Ashleyyyzamora/Ginhawa/docs/power-board-realistic.png

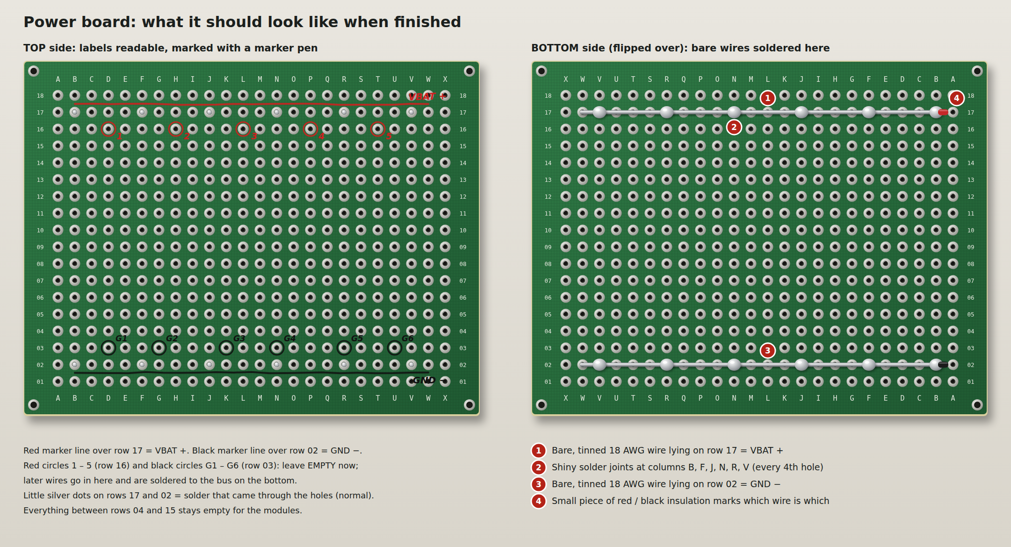
docs/power-board-realistic.png
