Ashleyyyzamora/Ginhawa/docs/power-board-what-to-look-for.png

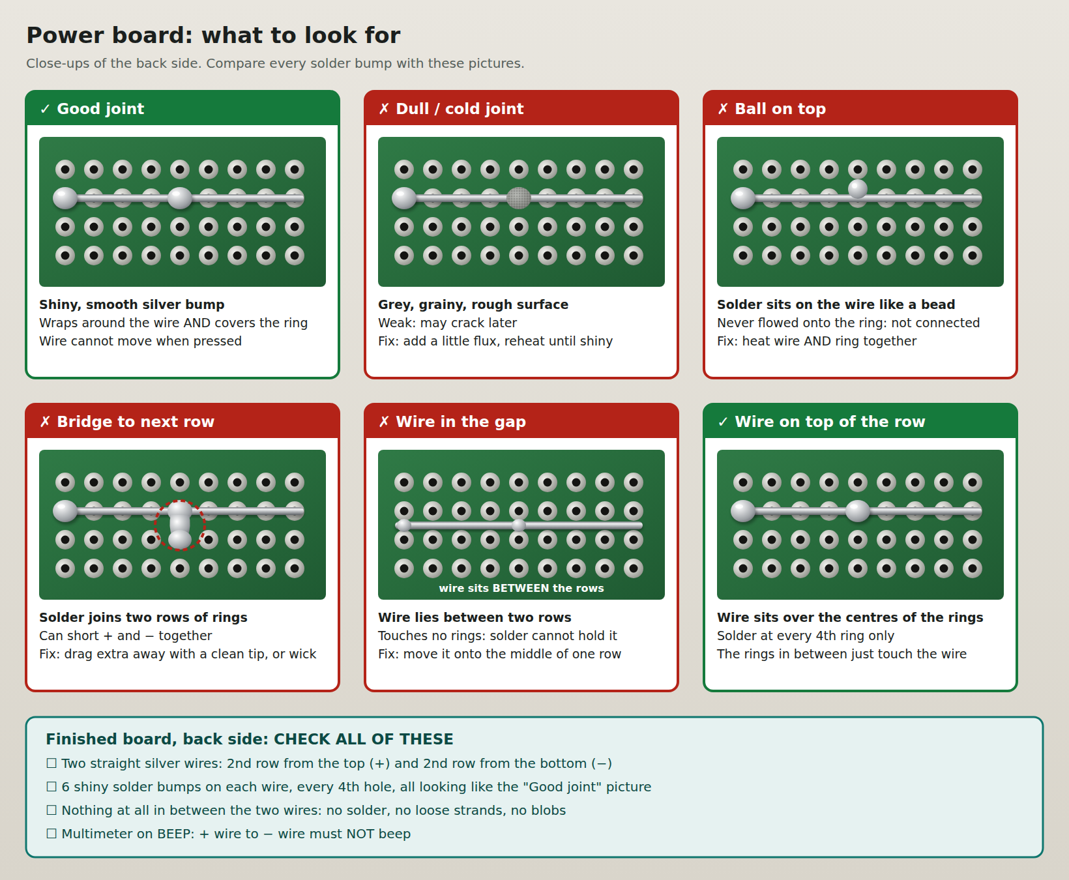
docs/power-board-what-to-look-for.png
