Ashleyyyzamora/Ginhawa/docs/power-board-layout.png

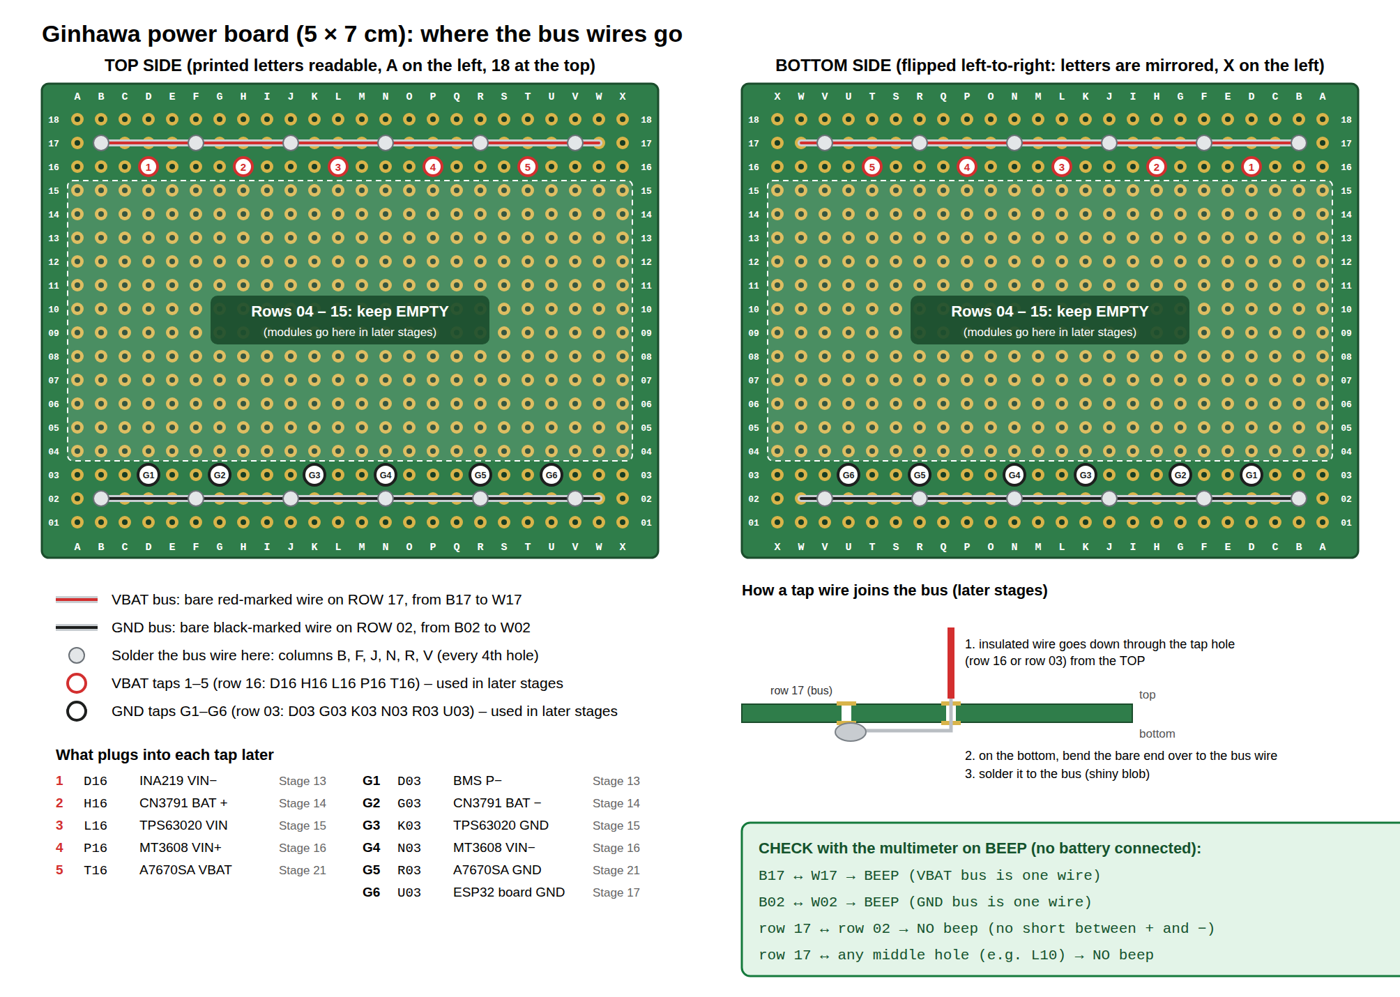
docs/power-board-layout.png
