Ashleyyyzamora/Ginhawa/docs/GINHAWA_Build_Manual_Diagrams.pdf

GINHAWA · AIR-QUALITY STATION

# Station Build Manual: Diagrams

All the figures from the build manual, one per page. Follow the full manual for the steps and checks.

1. Block diagram of the station power and data paths (Stage 1:
What you are building)
2. Parallel, series and short-circuit connections compared (Stage 2: Electricity in plain words)
3. Sketches of the tools needed for the build (Stage 4: Tools and workspace)
4. How to use a multimeter for voltage and continuity (Stage 6: Skill: using the multimeter)
5. Resistor colour bands for 4.7 kilo-ohm (Stage 6: Skill: using the multimeter)
6. Good and bad solder joints (Stage 7: Skill: soldering)
7. Four steps of through-hole soldering (Stage 7: Skill: soldering)
8. Four steps to solder a wire to a pad (Stage 7: Skill: soldering)
9. Practice perfboard with five soldering exercises (Stage 7: Skill: soldering)
10. Steps to strip, twist and tin a wire (Stage 8: Skill: wires, heat-shrink, headers and connectors)
11. Three steps to use heat-shrink tubing (Stage 8: Skill: wires, heat-shrink, headers and connectors)
12. How to cut a female header strip (Stage 8: Skill: wires, heat-shrink, headers and connectors)
13. Screw terminal, plug cable, JST GH and u.FL connectors (Stage 8: Skill: wires, heat-shrink, headers and connectors)
14. Battery holder with three cells in parallel (Stage 11: Build the battery pack)
15. Wiring of holder, BMS, fuse and INA219 (Stage 11: Build the battery pack)
16. Steps to make a bus wire on perfboard (Stage 12: Make the power board)
17. Power board layout with VBAT and GND bus wires (Stage 12: Make the power board)
18. Solar panel and CN3791 wiring (Stage 14: Solar panel and charger (CN3791))
19. TPS63020 and MT3608 wiring and adjustment (Stage 15: 3.3 V converter (TPS63020))
20. ESP32 DevKit V1 pinout with the used pins highlighted (Stage 17: Make the ESP32 board)
21. ESP32 board layout with rails and pull-up resistors (Stage 17: Make the ESP32 board)
22. Arduino IDE preferences dialog with the boards URL field (Stage 18: Install the Arduino IDE and drivers)
23. Windows Device Manager showing the ESP32 COM port (Stage 18: Install the Arduino IDE and drivers)
24. Labelled sketch of the Arduino IDE window (Stage 19: Your first program: Blink)
25. SEN55 connector pins and their connections (Stage 20: Connect the SEN55 and INA219, then test)

26. A7670SA breakout wiring with antennas and capacitors (Stage 21: Connect the 4G modem (A7670SA) and test)
27. Electrolytic capacitor polarity and parallel connection (Stage 21: Connect the 4G modem (A7670SA) and test)
28. Serial Monitor with baud rate and line ending settings (Stage 23: Upload the Ginhawa firmware)
29. Enclosure drilling plan and internal layout (Stage 25: Prepare the enclosure)
30. Steps to drill holes and cut a window in the box (Stage 25: Prepare the enclosure)
31. Pole mounting with tilted solar panel above the station box (Stage 27: Mount it outside)

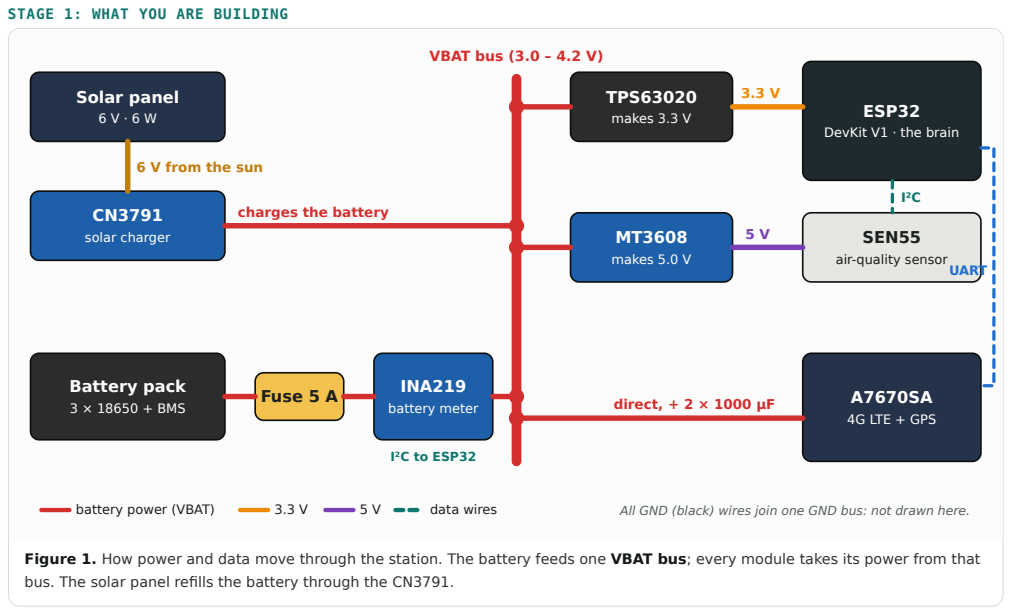
[picture p76: page 3]
VBAT bus (3.0 – 4.2 V); Solar panel; solar charger; Battery pack; 3 × 18650 + BMS; Fuse 5 A; INA219; battery meter; TPS63020; makes 3.3 V; makes 5.0 V; 4G LTE + GPS; direct, + 2 × 1000 µF; I²C; UART; I²C to ESP32; battery power (VBAT); data wires; All GND (black) wires join one GND bus: not drawn here.

STAGE 1: WHAT YOU ARE BUILDING

ESP32
DevKit V1 · the brain

6 V from the sun

charges the battery

SEN55
air-quality sensor

Figure 1. How power and data move through the station. The battery feeds one VBAT bus; every module takes its power from that
bus. The solar panel refills the battery through the CN3791.

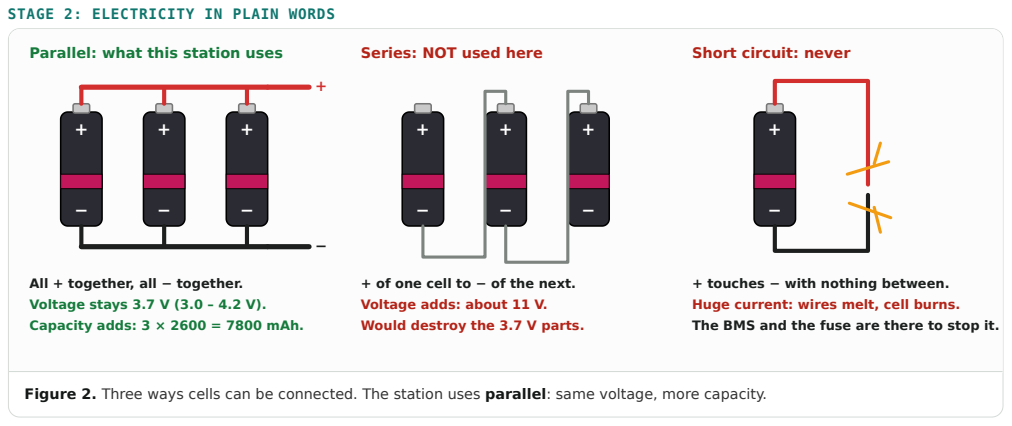
[picture p77: page 4]

STAGE 2: ELECTRICITY IN PLAIN WORDS

Parallel: what this station uses

Series: NOT used here

Short circuit: never

All + together, all − together.
Voltage stays 3.7 V (3.0 – 4.2 V).
Capacity adds: 3 × 2600 = 7800 mAh.

+ of one cell to − of the next.
Voltage adds: about 11 V.
Would destroy the 3.7 V parts.

+ touches − with nothing between.
Huge current: wires melt, cell burns.
The BMS and the fuse are there to stop it.

Figure 2. Three ways cells can be connected. The station uses parallel: same voltage, more capacity.

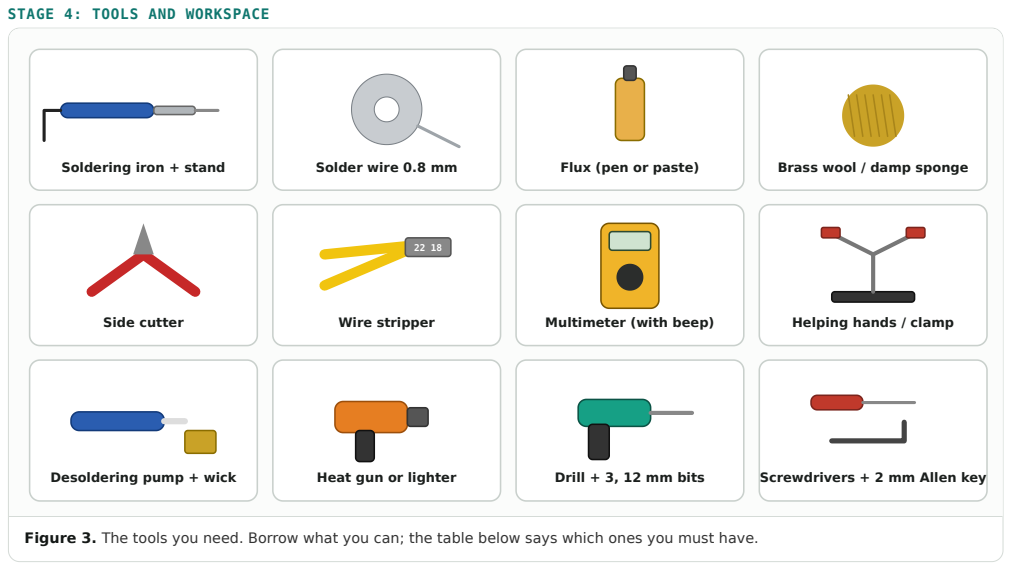
[picture p78: page 5]
Soldering iron + stand; Solder wire 0.8 mm; Flux (pen or paste); Brass wool / damp sponge; Side cutter; Wire stripper; Multimeter (with beep); Helping hands / clamp; Desoldering pump + wick; Heat gun or lighter; Drill + 3, 12 mm bits; Screwdrivers + 2 mm Allen key

STAGE 4: TOOLS AND WORKSPACE

Figure 3. The tools you need. Borrow what you can; the table below says which ones you must have.

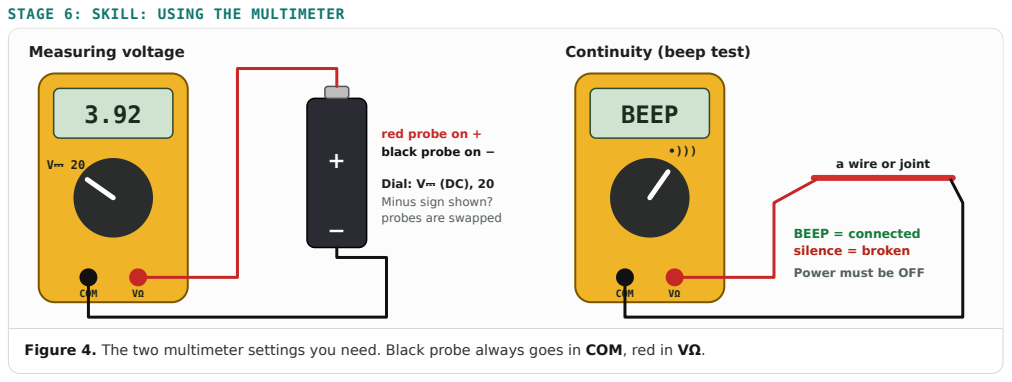
[picture p79: page 6]
Measuring voltage; COM; BEEP

STAGE 6: SKILL: USING THE MULTIMETER

Continuity (beep test)

red probe on +
black probe on −

a wire or joint

Dial: V⎓ (DC), 20
Minus sign shown?
probes are swapped

BEEP = connected
silence = broken
Power must be OFF

Figure 4. The two multimeter settings you need. Black probe always goes in COM, red in VΩ.

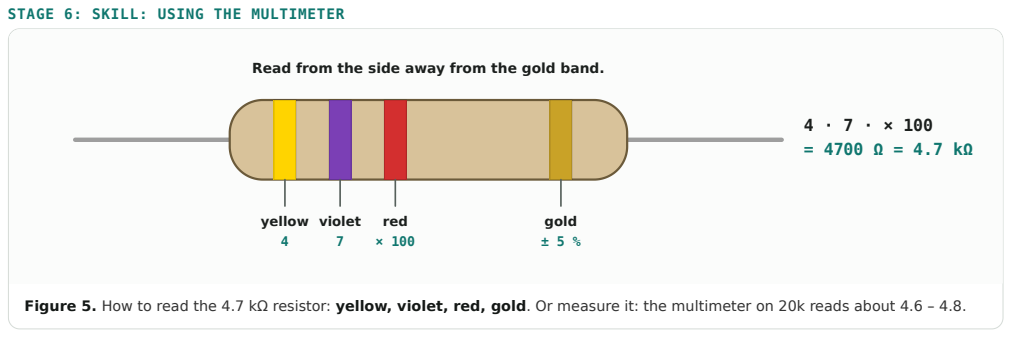
[picture p80: page 7]
yellow 4; violet 7; red × 100; gold ± 5 %

STAGE 6: SKILL: USING THE MULTIMETER

Read from the side away from the gold band.

Figure 5. How to read the 4.7 kΩ resistor: yellow, violet, red, gold. Or measure it: the multimeter on 20k reads about 4.6 – 4.8.

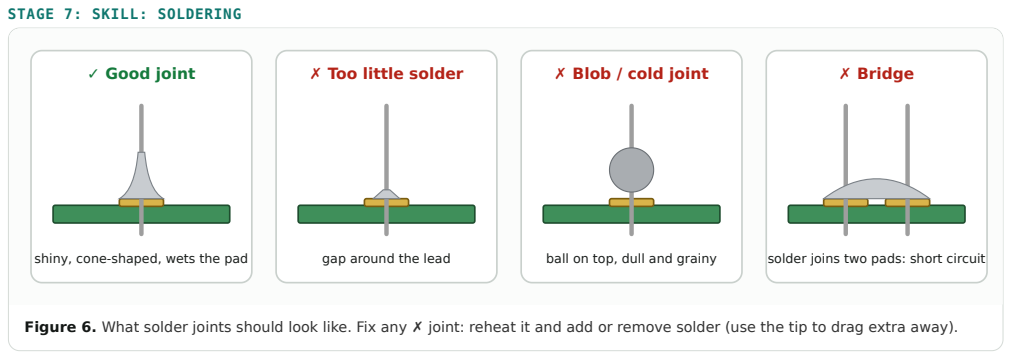
[picture p81: page 8]
✓ Good joint; ✗ Bridge

STAGE 7: SKILL: SOLDERING

✗ Too little solder

✗ Blob / cold joint

shiny, cone-shaped, wets the pad

gap around the lead

ball on top, dull and grainy

solder joins two pads: short circuit

Figure 6. What solder joints should look like. Fix any ✗ joint: reheat it and add or remove solder (use the tip to drag extra away).

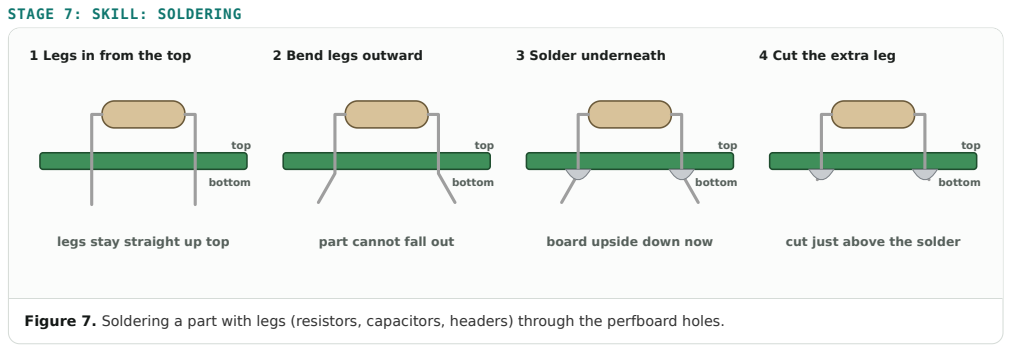
[picture p82: page 9]
top; bottom; 3 Solder underneath

STAGE 7: SKILL: SOLDERING

1 Legs in from the top

2 Bend legs outward

4 Cut the extra leg

legs stay straight up top

part cannot fall out

board upside down now

cut just above the solder

Figure 7. Soldering a part with legs (resistors, capacitors, headers) through the perfboard holes.

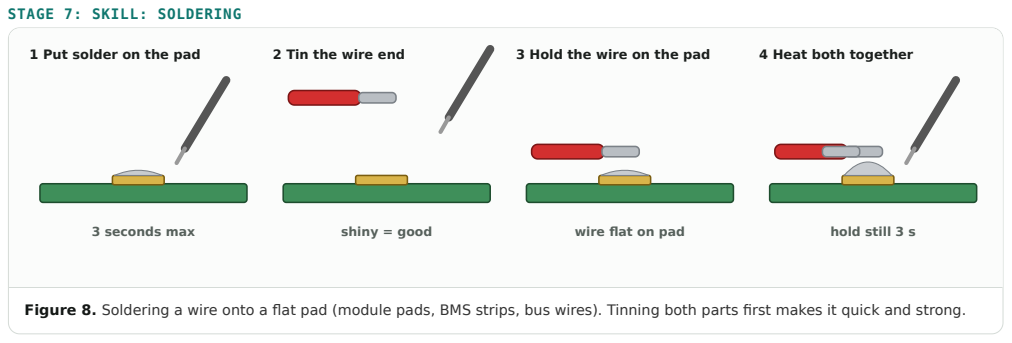
[picture p83: page 10]
3 seconds max; shiny = good; hold still 3 s

STAGE 7: SKILL: SOLDERING

1 Put solder on the pad

2 Tin the wire end

3 Hold the wire on the pad

4 Heat both together

wire flat on pad

Figure 8. Soldering a wire onto a flat pad (module pads, BMS strips, bus wires). Tinning both parts first makes it quick and strong.

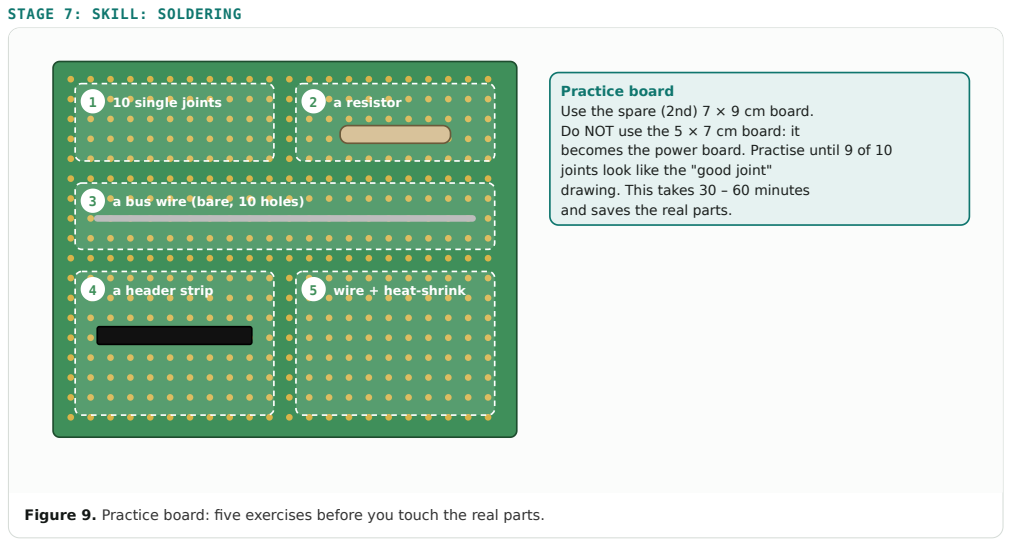
[picture p84: page 11]
1 10 single joints; 2 a resistor; 4 a header strip; 5 wire + heat-shrink

STAGE 7: SKILL: SOLDERING

Practice board
Use the spare (2nd) 7 × 9 cm board.
Do NOT use the 5 × 7 cm board: it
becomes the power board. Practise until 9 of 10
joints look like the "good joint"
drawing. This takes 30 – 60 minutes
and saves the real parts.

3 a bus wire (bare, 10 holes)

Figure 9. Practice board: five exercises before you touch the real parts.

STAGE 8: SKILL: WIRES, HEAT-SHRINK, HEADERS AND CONNECTORS

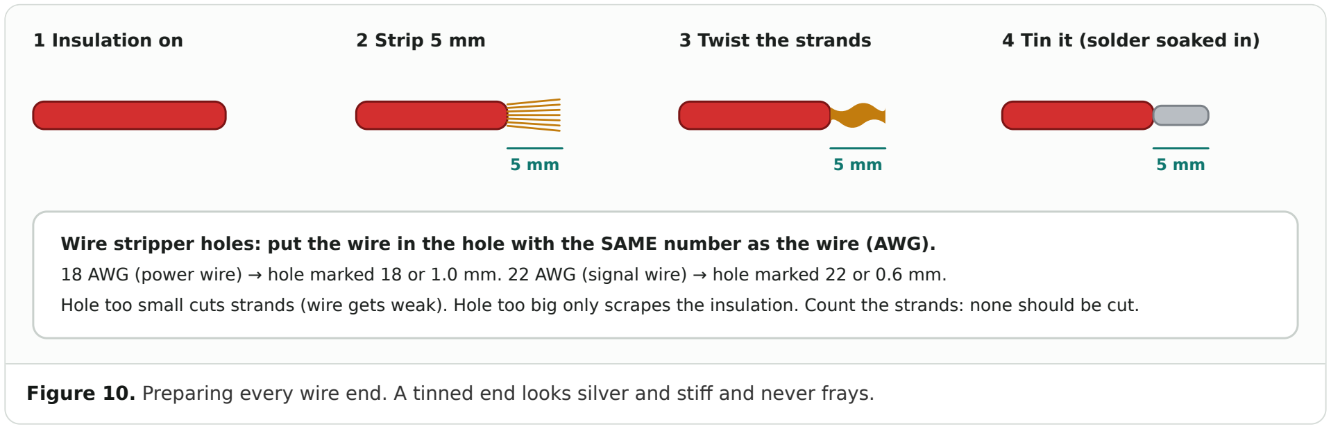
[picture p85: figure]
1 Insulation on; 2 Strip 5 mm; 3 Twist the strands; 4 Tin it (solder soaked in)

Wire stripper holes: put the wire in the hole with the SAME number as the wire (AWG).
18 AWG (power wire) → hole marked 18 or 1.0 mm. 22 AWG (signal wire) → hole marked 22 or 0.6 mm.
Hole too small cuts strands (wire gets weak). Hole too big only scrapes the insulation. Count the strands: none should be cut.

Figure 10. Preparing every wire end. A tinned end looks silver and stiff and never frays.

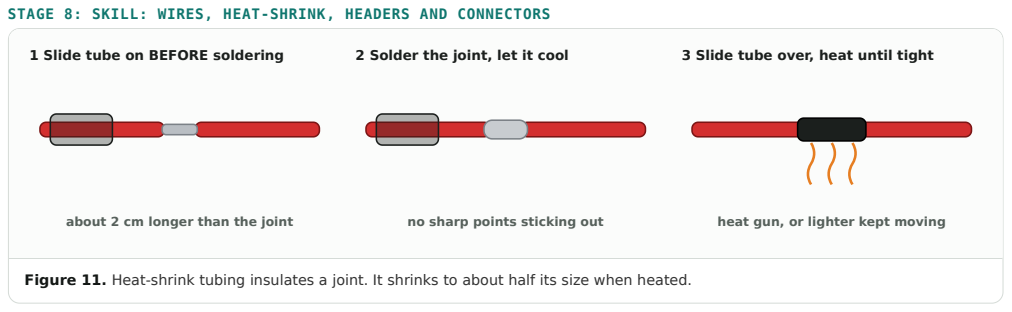
[picture p86: page 13]

STAGE 8: SKILL: WIRES, HEAT-SHRINK, HEADERS AND CONNECTORS

1 Slide tube on BEFORE soldering

2 Solder the joint, let it cool

3 Slide tube over, heat until tight

about 2 cm longer than the joint

no sharp points sticking out

heat gun, or lighter kept moving

Figure 11. Heat-shrink tubing insulates a joint. It shrinks to about half its size when heated.

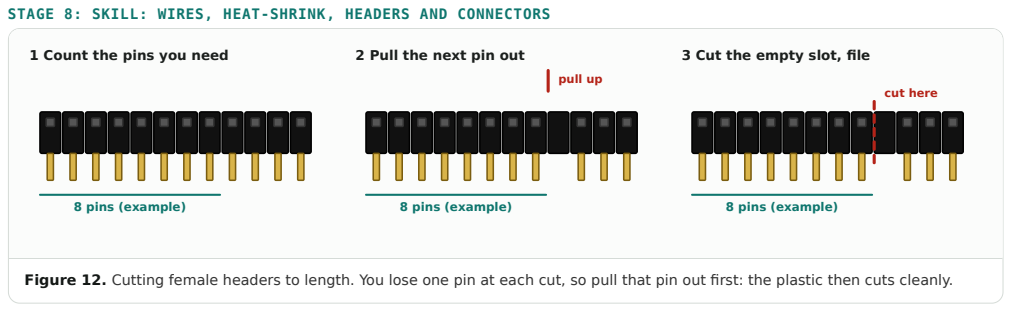
[picture p87: page 14]
8 pins (example); pull up; cut here

STAGE 8: SKILL: WIRES, HEAT-SHRINK, HEADERS AND CONNECTORS

1 Count the pins you need

2 Pull the next pin out

3 Cut the empty slot, file

Figure 12. Cutting female headers to length. You lose one pin at each cut, so pull that pin out first: the plastic then cuts cleanly.

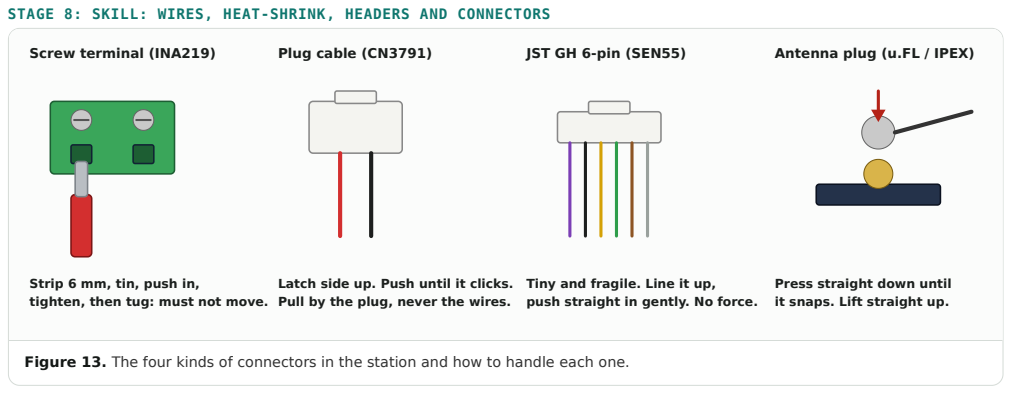
[picture p88: page 15]
Screw terminal (INA219); Plug cable (CN3791)

STAGE 8: SKILL: WIRES, HEAT-SHRINK, HEADERS AND CONNECTORS

JST GH 6-pin (SEN55)

Antenna plug (u.FL / IPEX)

Strip 6 mm, tin, push in,
tighten, then tug: must not move.

Latch side up. Push until it clicks.
Pull by the plug, never the wires.

Tiny and fragile. Line it up,
push straight in gently. No force.

Press straight down until
it snaps. Lift straight up.

Figure 13. The four kinds of connectors in the station and how to handle each one.

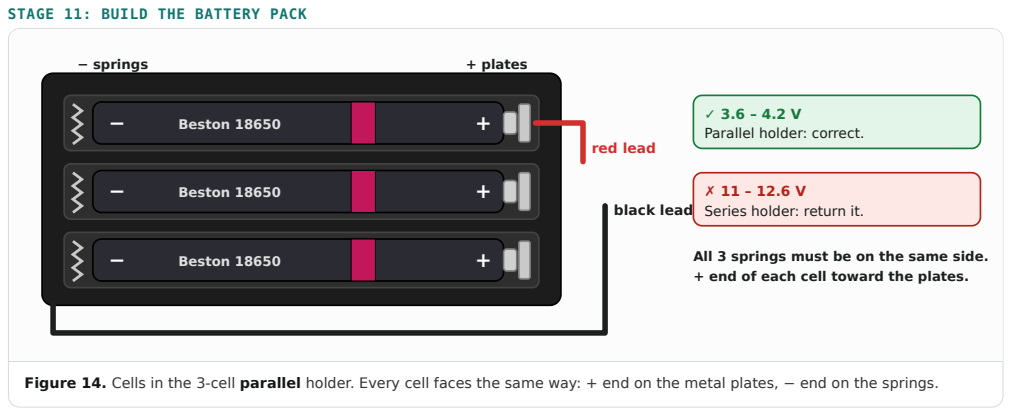
[picture p89: page 16]
Beston 18650; − springs; + plates; red lead; black lead

STAGE 11: BUILD THE BATTERY PACK

Parallel holder: correct.

Series holder: return it.

All 3 springs must be on the same side.
+ end of each cell toward the plates.

Figure 14. Cells in the 3-cell parallel holder. Every cell faces the same way: + end on the metal plates, − end on the springs.

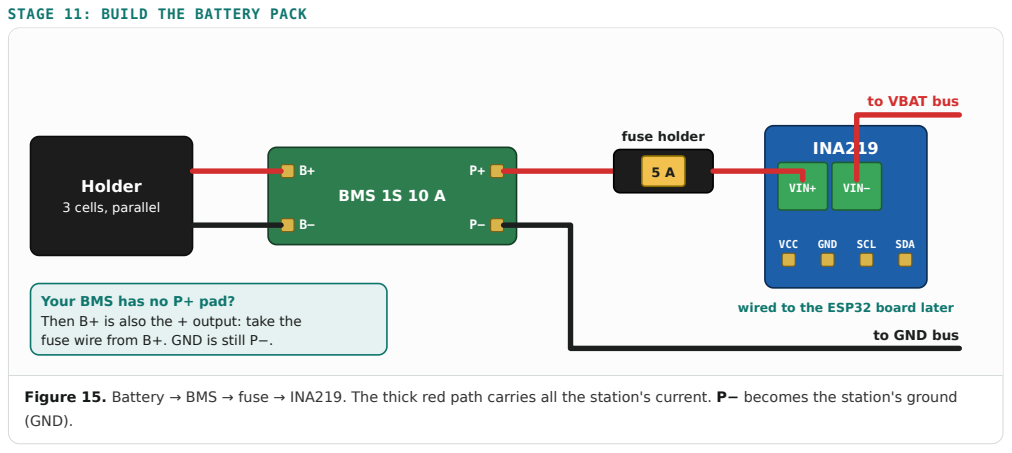
[picture p90: page 17]
Holder; 3 cells, parallel; BMS 1S 10 A; fuse holder; INA219; VIN+; VIN−; VCC; GND; SCL; SDA

STAGE 11: BUILD THE BATTERY PACK

to VBAT bus

Your BMS has no P+ pad?
Then B+ is also the + output: take the
fuse wire from B+. GND is still P−.

wired to the ESP32 board later

to GND bus

Figure 15. Battery → BMS → fuse → INA219. The thick red path carries all the station's current. P− becomes the station's ground
(GND).

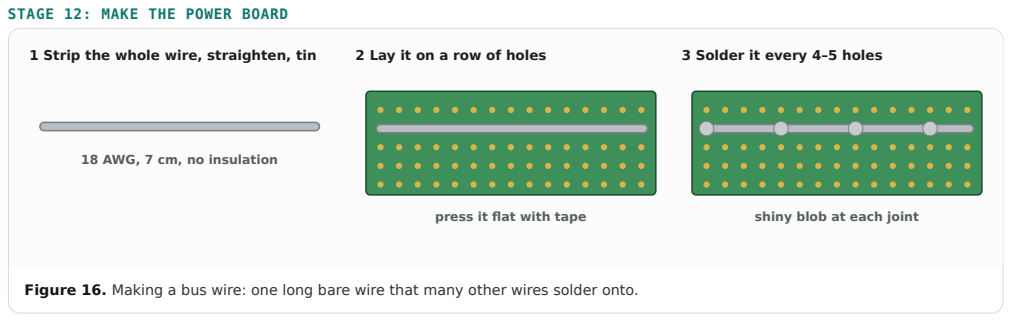
[picture p91: page 18]

STAGE 12: MAKE THE POWER BOARD

1 Strip the whole wire, straighten, tin

2 Lay it on a row of holes

3 Solder it every 4–5 holes

18 AWG, 7 cm, no insulation

press it flat with tape

shiny blob at each joint

Figure 16. Making a bus wire: one long bare wire that many other wires solder onto.

STAGE 12: MAKE THE POWER BOARD

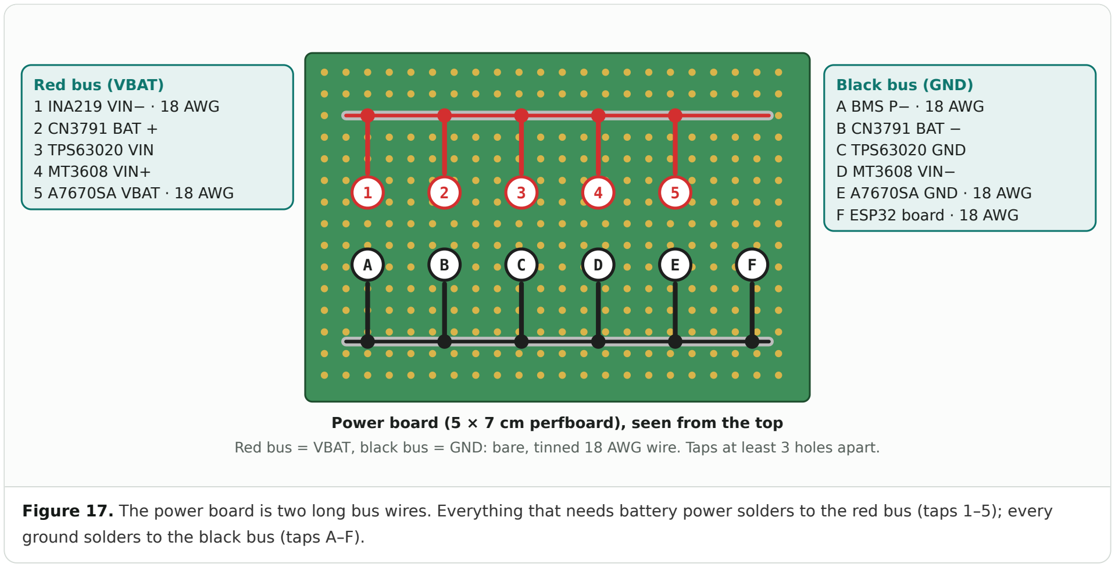
[picture p92: figure]
Red bus (VBAT) 1 INA219 VIN− · 18 AWG 2 CN3791 BAT + 3 TPS63020 VIN 4 MT3608 VIN+ 5 A7670SA VBAT · 18 AWG; Black bus (GND) A BMS P− · 18 AWG B CN3791 BAT − C TPS63020 GND D MT3608 VIN− E A7670SA GND · 18 AWG F ESP32 board · 18 AWG

Power board (5 × 7 cm perfboard), seen from the top Red bus = VBAT, black bus = GND: bare, tinned 18 AWG wire. Taps at least 3 holes apart.

Figure 17. The power board is two long bus wires. Everything that needs battery power solders to the red bus (taps 1–5); every ground solders to the black bus (taps A–F).

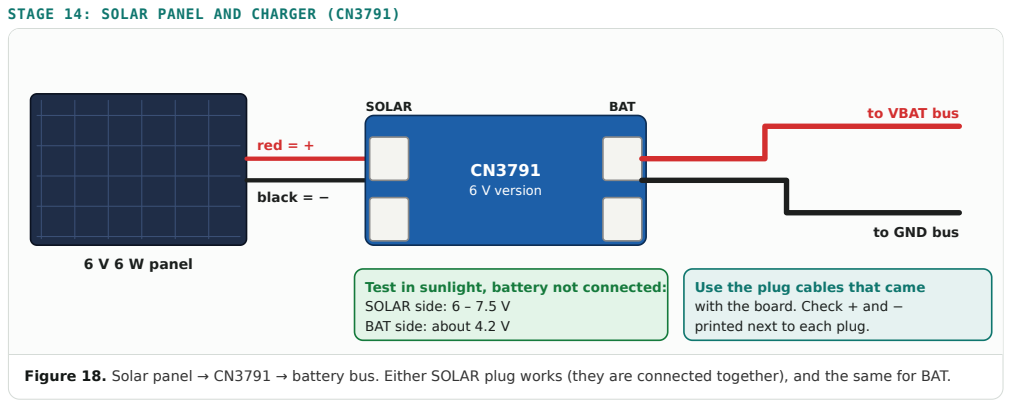
[picture p93: page 20]
6 V 6 W panel; red = +; black = −; CN3791 6 V version; SOLAR; BAT

STAGE 14: SOLAR PANEL AND CHARGER (CN3791)

to VBAT bus

to GND bus

Test in sunlight, battery not connected:
SOLAR side: 6 – 7.5 V
BAT side: about 4.2 V

Use the plug cables that came
with the board. Check + and −
printed next to each plug.

Figure 18. Solar panel → CN3791 → battery bus. Either SOLAR plug works (they are connected together), and the same for BAT.

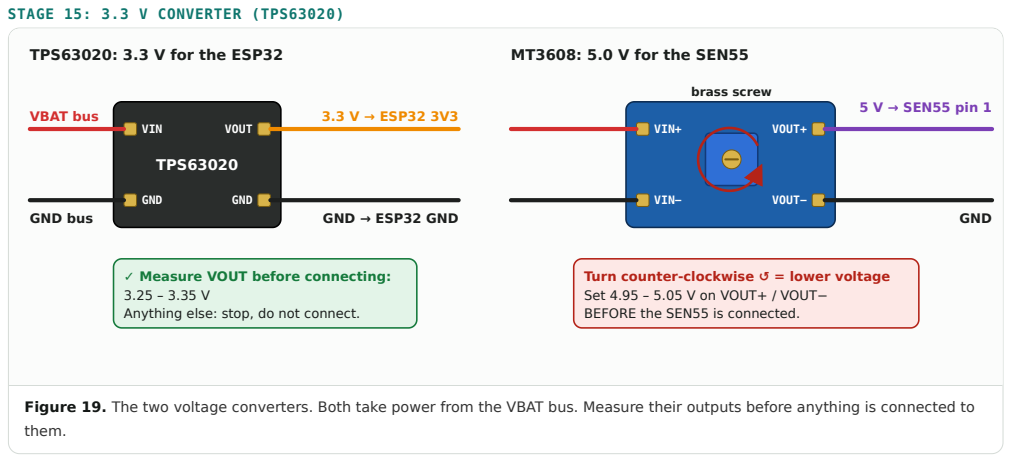
[picture p94: page 21]
STAGE 15: 3.3 V CONVERTER (TPS63020); TPS63020: 3.3 V for the ESP32; TPS63020; VIN; GND; VOUT; VBAT bus; GND bus; 3.3 V → ESP32 3V3; GND → ESP32 GND; MT3608: 5.0 V for the SEN55; VIN+; VIN−; VOUT+; VOUT−; brass screw; 5 V → SEN55 pin 1

✓ Measure VOUT before connecting:
Anything else: stop, do not connect.

Turn counter-clockwise ↺ = lower voltage
Set 4.95 – 5.05 V on VOUT+ / VOUT−
BEFORE the SEN55 is connected.

Figure 19. The two voltage converters. Both take power from the VBAT bus. Measure their outputs before anything is connected to
them.

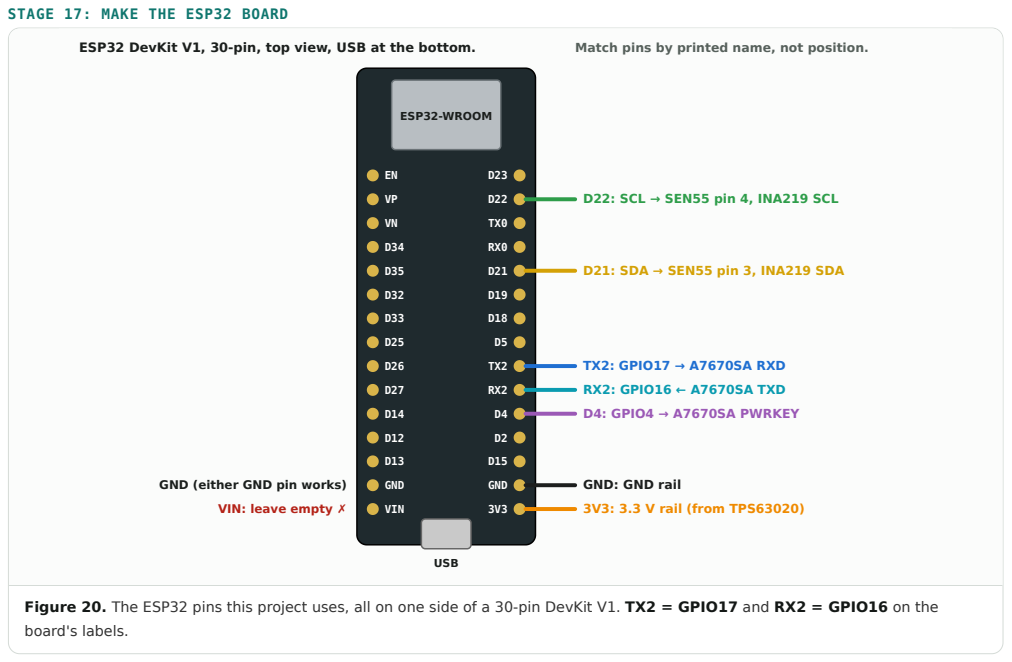
[picture p95: page 22]

STAGE 17: MAKE THE ESP32 BOARD

Figure 20. The ESP32 pins this project uses, all on one side of a 30-pin DevKit V1. TX2 = GPIO17 and RX2 = GPIO16 on the
board's labels.

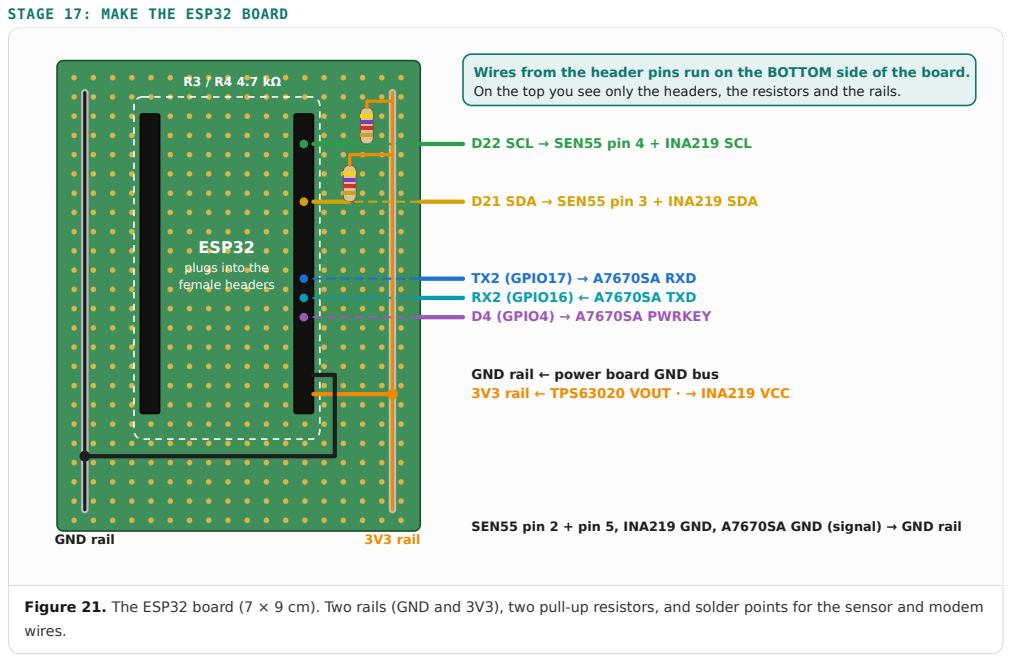
[picture p96: page 23]
GND rail; 3V3 rail; TX2 (GPIO17) → A7670SA RXD RX2 (GPIO16) ← A7670SA TXD D4 (GPIO4) → A7670SA PWRKEY

STAGE 17: MAKE THE ESP32 BOARD

Wires from the header pins run on the BOTTOM side of the board.
On the top you see only the headers, the resistors and the rails.

D22 SCL → SEN55 pin 4 + INA219 SCL

D21 SDA → SEN55 pin 3 + INA219 SDA

ESP32
plugs into the
female headers

GND rail ← power board GND bus
3V3 rail ← TPS63020 VOUT · → INA219 VCC

SEN55 pin 2 + pin 5, INA219 GND, A7670SA GND (signal) → GND rail

Figure 21. The ESP32 board (7 × 9 cm). Two rails (GND and 3V3), two pull-up resistors, and solder points for the sensor and modem
wires.

STAGE 18: INSTALL THE ARDUINO IDE AND DRIVERS

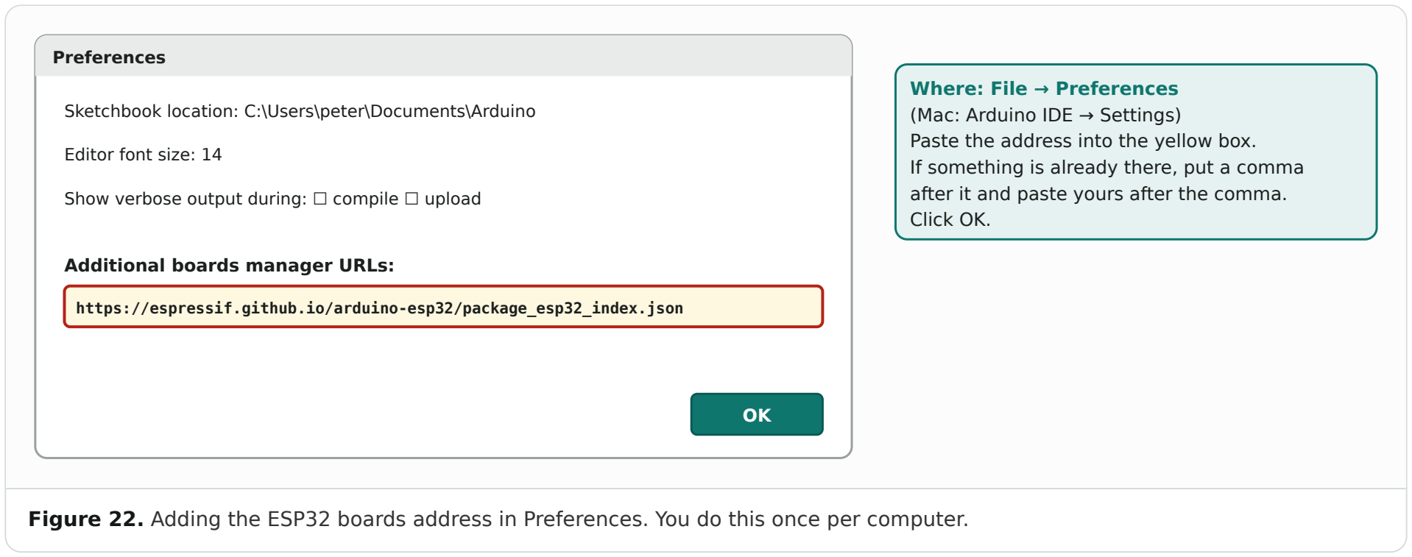
[picture p97: figure]
Preferences; Sketchbook location: C:\Users\peter\Documents\Arduino; Editor font size: 14; Additional boards manager URLs:; https://espressif.github.io/arduino-esp32/package_esp32_index.json; Where: File → Preferences (Mac: Arduino IDE → Settings) Paste the address into the yellow box.; Click OK.

Show verbose output during: ☐ compile ☐ upload

If something is already there, put a comma after it and paste yours after the comma.

Figure 22. Adding the ESP32 boards address in Preferences. You do this once per computer.

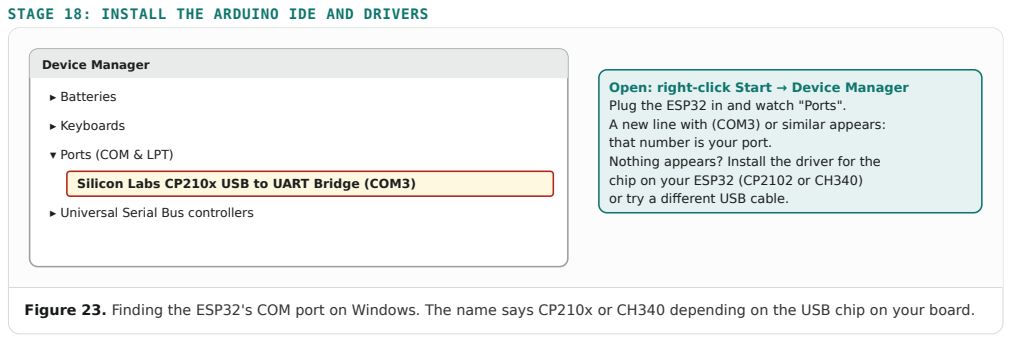
[picture p98: page 25]
Device Manager; ▸ Batteries; ▸ Keyboards

STAGE 18: INSTALL THE ARDUINO IDE AND DRIVERS

Open: right-click Start → Device Manager
Plug the ESP32 in and watch "Ports".
A new line with (COM3) or similar appears:
that number is your port.
Nothing appears? Install the driver for the
chip on your ESP32 (CP2102 or CH340)
or try a different USB cable.

▾ Ports (COM & LPT)

Silicon Labs CP210x USB to UART Bridge (COM3)

▸ Universal Serial Bus controllers

Figure 23. Finding the ESP32's COM port on Windows. The name says CP210x or CH340 depending on the USB chip on your board.

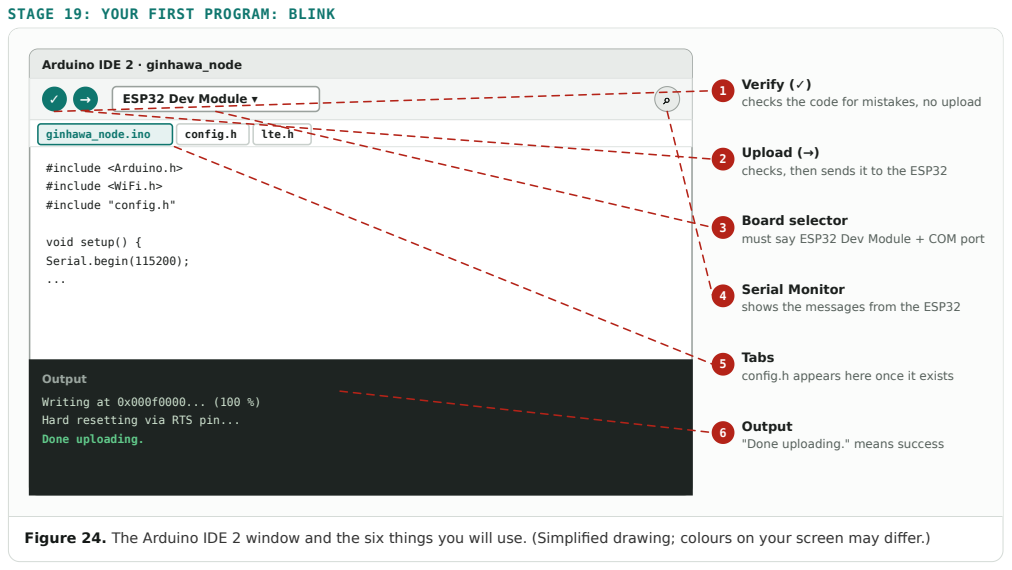
[picture p99: page 26]
Arduino IDE 2 · ginhawa_node; ESP32 Dev Module ▾; ginhawa_node.ino; config.h; lte.h; #include <Arduino.h> #include <WiFi.h> #include "config.h"; void setup() { Serial.begin(115200); ...

STAGE 19: YOUR FIRST PROGRAM: BLINK

1 Verify (✓)
checks the code for mistakes, no upload

2 Upload (→)
checks, then sends it to the ESP32

3 Board selector
must say ESP32 Dev Module + COM port

Serial Monitor
shows the messages from the ESP32

Tabs
config.h appears here once it exists

Output
Writing at 0x000f0000... (100 %)
Hard resetting via RTS pin...
Done uploading.

6 Output
"Done uploading." means success

Figure 24. The Arduino IDE 2 window and the six things you will use. (Simplified drawing; colours on your screen may differ.)

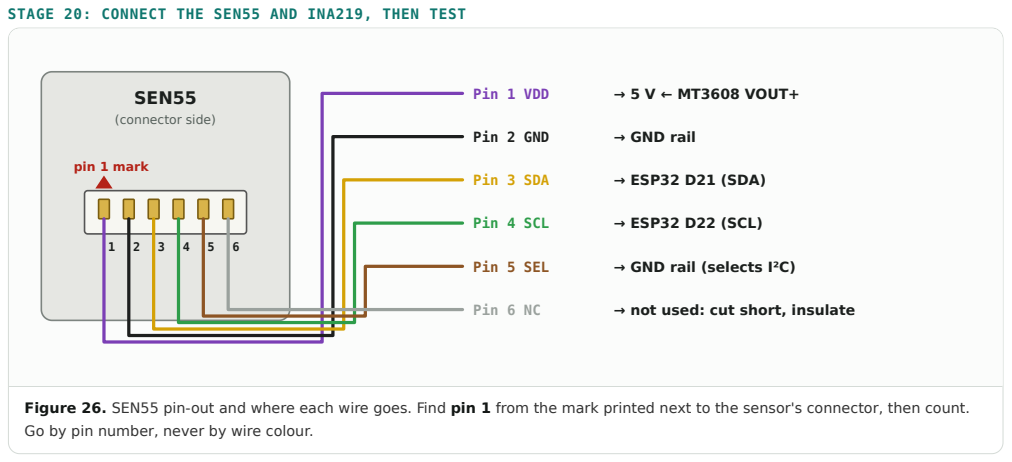
[picture p100: page 27]
SEN55; (connector side); Pin 1 VDD; → 5 V ← MT3608 VOUT+; Pin 2 GND; → GND rail; Pin 3 SDA; → ESP32 D21 (SDA); Pin 4 SCL; → ESP32 D22 (SCL); Pin 5 SEL; → GND rail (selects I²C); Pin 6 NC; → not used: cut short, insulate; pin 1 mark

STAGE 20: CONNECT THE SEN55 AND INA219, THEN TEST

Figure 26. SEN55 pin-out and where each wire goes. Find pin 1 from the mark printed next to the sensor's connector, then count.
Go by pin number, never by wire colour.

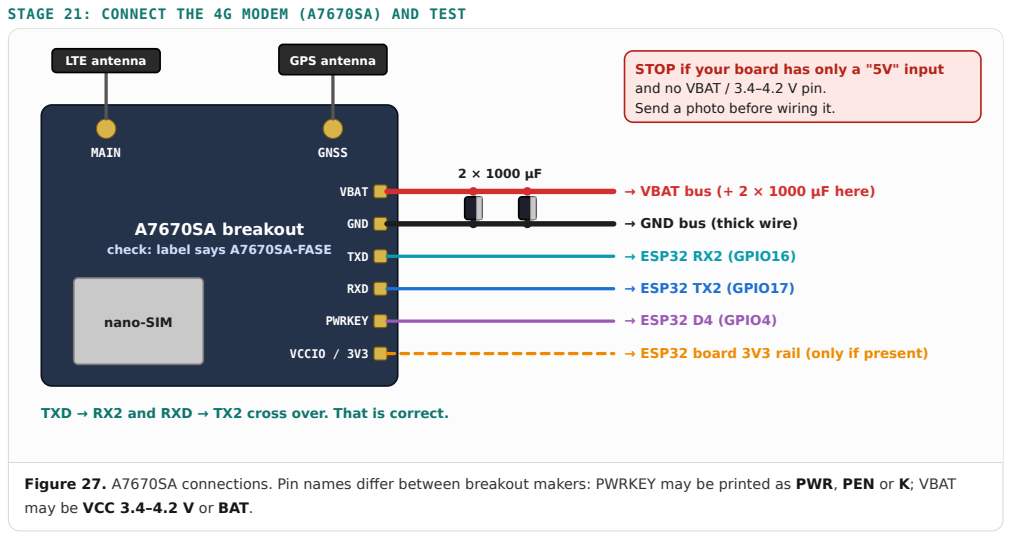
[picture p101: page 28]
nano-SIM; MAIN; GNSS; LTE antenna; GPS antenna; VBAT; → VBAT bus (+ 2 × 1000 µF here); GND; → GND bus (thick wire); TXD; → ESP32 RX2 (GPIO16); RXD; → ESP32 TX2 (GPIO17); PWRKEY; → ESP32 D4 (GPIO4); VCCIO / 3V3; → ESP32 board 3V3 rail (only if present)

STAGE 21: CONNECT THE 4G MODEM (A7670SA) AND TEST

STOP if your board has only a "5V" input
and no VBAT / 3.4–4.2 V pin.
Send a photo before wiring it.

A7670SA breakout
check: label says A7670SA-FASE

TXD → RX2 and RXD → TX2 cross over. That is correct.

Figure 27. A7670SA connections. Pin names differ between breakout makers: PWRKEY may be printed as PWR, PEN or K; VBAT
may be VCC 3.4–4.2 V or BAT.

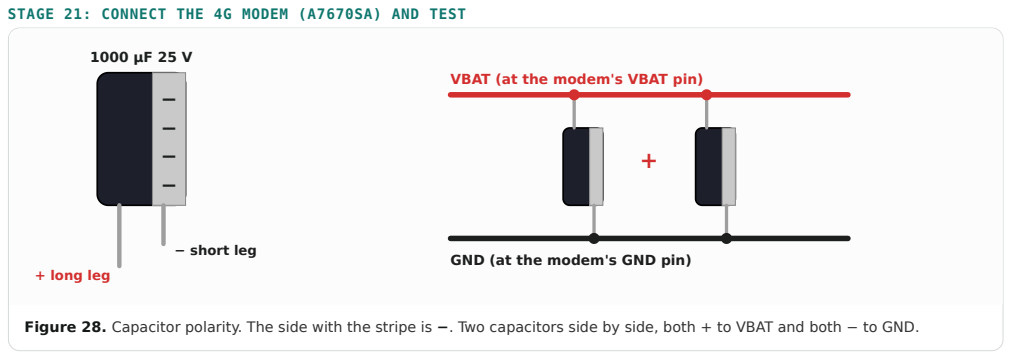
[picture p102: page 29]
+ long leg; − short leg

STAGE 21: CONNECT THE 4G MODEM (A7670SA) AND TEST

VBAT (at the modem's VBAT pin)

GND (at the modem's GND pin)

Figure 28. Capacitor polarity. The side with the stripe is −. Two capacitors side by side, both + to VBAT and both − to GND.

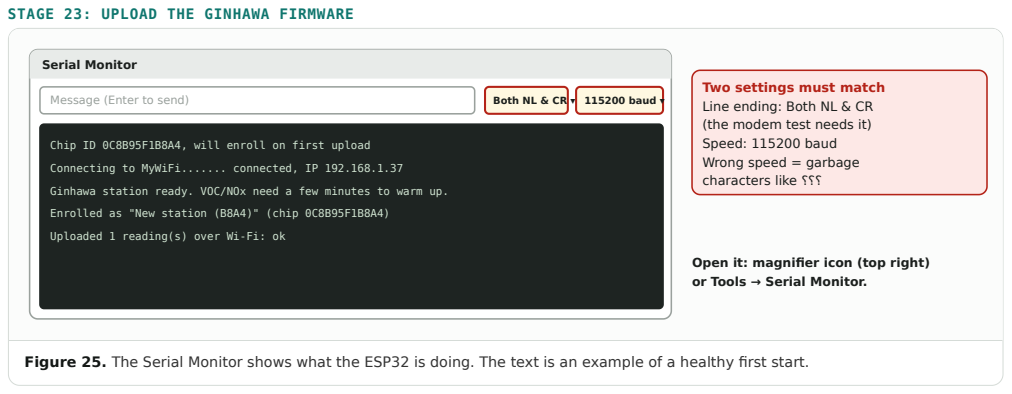
[picture p103: page 30]
Serial Monitor; Message (Enter to send); Both NL & CR ▾ 115200 baud ▾

STAGE 23: UPLOAD THE GINHAWA FIRMWARE

Two settings must match
Line ending: Both NL & CR
(the modem test needs it)
Speed: 115200 baud
Wrong speed = garbage
characters like ⸮⸮⸮

Chip ID 0C8B95F1B8A4, will enroll on first upload
Connecting to MyWiFi....... connected, IP 192.168.1.37
Ginhawa station ready. VOC/NOx need a few minutes to warm up.
Enrolled as "New station (B8A4)" (chip 0C8B95F1B8A4)
Uploaded 1 reading(s) over Wi-Fi: ok

Open it: magnifier icon (top right)
or Tools → Serial Monitor.

Figure 25. The Serial Monitor shows what the ESP32 is doing. The text is an example of a healthy first start.

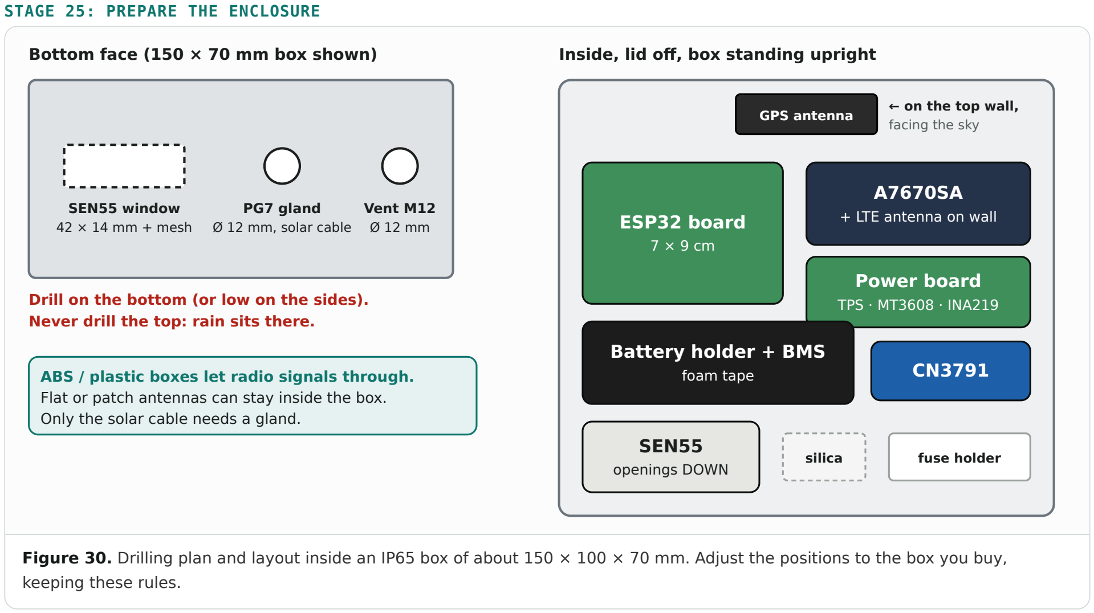
[picture p104: figure]
STAGE 25: PREPARE THE ENCLOSURE; Bottom face (150 × 70 mm box shown); SEN55 window 42 × 14 mm + mesh; PG7 gland Ø 12 mm, solar cable; Vent M12 Ø 12 mm; Never drill the top: rain sits there.; Inside, lid off, box standing upright; GPS antenna; ← on the top wall, facing the sky; ESP32 board; + LTE antenna on wall; Power board; TPS · MT3608 · INA219; Battery holder + BMS; foam tape; SEN55; openings DOWN; silica; fuse holder; Only the solar cable needs a gland.; keeping these rules.

Drill on the bottom (or low on the sides).

ABS / plastic boxes let radio signals through. Flat or patch antennas can stay inside the box.

Figure 30. Drilling plan and layout inside an IP65 box of about 150 × 100 × 70 mm. Adjust the positions to the box you buy,

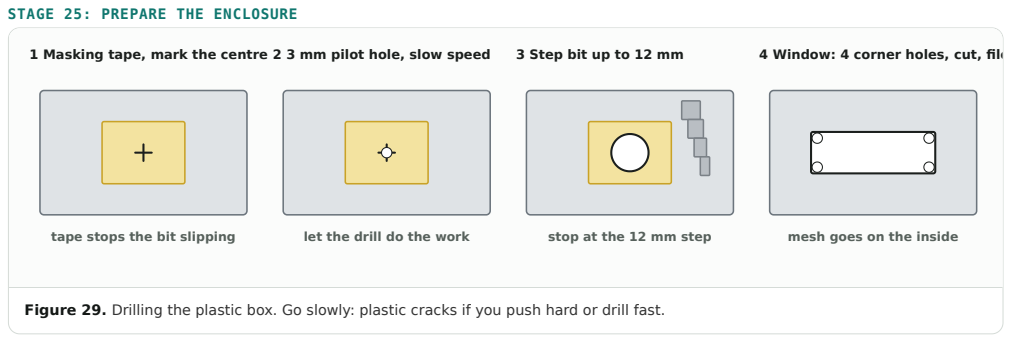
[picture p105: page 32]

STAGE 25: PREPARE THE ENCLOSURE

1 Masking tape, mark the centre

2 3 mm pilot hole, slow speed

3 Step bit up to 12 mm

4 Window: 4 corner holes, cut, file

tape stops the bit slipping

let the drill do the work

stop at the 12 mm step

mesh goes on the inside

Figure 29. Drilling the plastic box. Go slowly: plastic cracks if you push hard or drill fast.

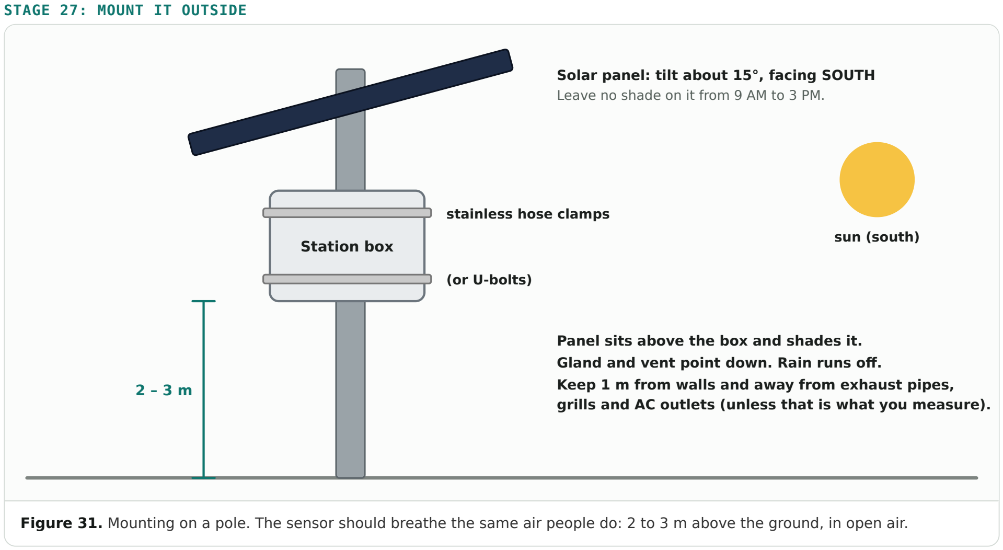
[picture p106: figure]
STAGE 27: MOUNT IT OUTSIDE; Leave no shade on it from 9 AM to 3 PM.; Station box; stainless hose clamps; (or U-bolts); sun (south); Panel sits above the box and shades it.

Solar panel: tilt about 15°, facing SOUTH

Gland and vent point down. Rain runs off.
Keep 1 m from walls and away from exhaust pipes, grills and AC outlets (unless that is what you measure).

Figure 31. Mounting on a pole. The sensor should breathe the same air people do: 2 to 3 m above the ground, in open air.
