Ashleyyyzamora/Ginhawa/(commit log)

2026-09-26 Add Ginhawa air-quality monitoring stack
    Node.js REST API + WebSocket server with PostgreSQL, a mobile-first React
    app, Docker Compose deployment behind Caddy (HTTPS), an ESP32 + SEN55
    firmware sketch, and a data simulator for demos.
    Claude-Session: https://claude.ai/code/session_0148MYiEDhLTPmdz34XuceJs
2026-09-26 Turn devices into shared, location-named stations
    - Each device is a station named after where it is placed (e.g. Barangay
    Carmen) with an optional landmark; name + landmark must be unique
    - Drop GPS coordinates; rename location -> landmark (migration 002)
    - Stations, readings and alerts are visible to every signed-in user;
    only the creator can edit, delete or rotate the key (403 otherwise)
    - WebSocket events are broadcast to all users, incl. device_created
    - Simulator uses generic placeholder stations; migration removes the old
    mock 'Sim · ' sites
    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
2026-09-26 Add light/dark/system theme and IQAir/Apple Weather-style UI
    Theme
    - System / Light / Dark preference stored per device, applied via
    <html data-theme> before first paint (no flash); header quick toggle,
    Account > Appearance picker; charts follow the active theme
    UI/UX (IQAir + Apple Weather as reference)
    - Station page: level-coloured AQI hero with main pollutant, temperature,
    humidity and AQI scale; health recommendations; hourly AQI strip for the
    last 12 hours; reading tiles with gauges
    - Home: level-tinted station cards with large AQI, restyled overview
    - Large titles that collapse into a compact bar on scroll
    - Grouped iOS-style lists on Account, new toasts/sheets styling
    - Rewr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
2026-09-26 Add revised system architecture diagram (SVG + PNG)
    Matches the implemented system: SEN55 + LilyGO T-SIM7600 node, battery
    as primary power with solar charging, Wi-Fi with LTE fallback, HTTPS
    ingest via Caddy to Node.js/Express, WebSocket live updates, PostgreSQL,
    React PWA, developer/viewer roles.
    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
2026-09-26 Add draw.io architecture, block and circuit diagrams; fix LED pins
    - docs/diagrams: editable .drawio + PNG for the system architecture
    (deployment view), station hardware block diagram and circuit schematic
    (standard symbols, pin numbers, BOM, title block)
    - Battery monitoring via INA219 on the I2C bus: the T-SIM7600 exposes no
    free ADC1 pin (IO32-36 are wired to the modem/on-board ADCs)
    - Firmware config: status LEDs moved to IO18/IO19; IO25/IO26 are the
    SIM7600 FLIGHT/RX pins on this board
    - Replaces the earlier hand-drawn architecture SVG
    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
    [config.example.h, ginhawa_node.ino]
2026-09-26 Add Agile Scrum methodology infographic (SVG + PNG)
    Scrum framework applied to Ginhawa: product backlog, sprint planning,
    2-week sprint with daily scrum, design/develop/test, review,
    retrospective, release and pilot deployment in Barangay Carmen, plus
    the three Scrum roles.
    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
2026-09-26 Rework diagrams for print: larger text, compact layouts, white background
    - Architecture and block diagrams rebuilt as portrait layouts (~1000 px
    wide) so body text is ~8-9 pt at full page width; darker strokes/text
    - Schematic compacted to two rows with 20-22 px labels; notes and BOM
    moved to 03-circuit-notes.md
    - Scrum infographic rebuilt at 1200 px with larger labels, shorter
    descriptions; in-figure titles removed (captions live in the paper)
    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
2026-09-26 Revise proposal per panel minutes; add ERD, use case, context, DFD, flowchart, Gantt
    - docs/proposal: rearranged and revised proposal (.docx + PDF preview) and
    a summary-of-revisions matrix mapping every panel comment to its fix
    - New draw.io diagrams in one consistent notation: crow's-foot ERD, UML
    use case (human actors only), Gane-Sarson context diagram and DFD,
    ANSI flowchart; new Gantt chart with deployment phases
    - Hardware diagrams updated: 12.8 V 12 Ah LiFePO4, SIM7600G-H GNSS
    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
2026-09-26 Compact station design: 1S LiFePO4 32700 pack, 10 W panel, power-saving schedule
    - Replace 12.8 V 12 Ah LiFePO4 + 12 V controller + buck with 4x 32700
    LiFePO4 cells (3.2 V 24 Ah) + 1S BMS, 1S LiFePO4 solar charger,
    6 V 10 W panel and 3.2->5 V boost; enclosure 200x120x75 mm
    - Power-saving schedule (PM 1 min in 5, 1-min uploads): ~14.4 Wh/day,
    ~4.3 days without sun; updated diagrams, proposal, BOM and costing
    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
2026-09-26 Match app data to the compact station's power-saving schedule
    - Carry the last PM measurement forward for up to 10 minutes, so the AQI
    stays continuous while PM is measured 1 minute in every 5
    (pm_recorded_at is exposed)
    - Mark a station offline after 5 minutes without an upload
    - Store battery voltage/current, network (wifi/lte) and GPS position
    (migration 003); add a Station status card to the station screen
    - Plot only measured PM in the live chart
    - Firmware and simulator use the duty-cycled schedule with 1-minute uploads
    - Revise the proposal and Summary of Revisions for the app behavior
    and the new screenshots
    Claude-Sess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
2026-09-30 Switch the station to the team's ESP32 DevKit and 18650 Li-ion cells
    - Hardware: ESP32 DevKit V1 with separate A7670 LTE and ATGM336H GPS
    modules instead of the LilyGO T-SIM7600; 3x 18650 (1S3P, ~33 Wh),
    CN3791 charger, 6 V 6 W panel, 3.3 V buck-boost and 5 V boost,
    150 x 100 x 70 mm enclosure
    - Firmware: Wi-Fi first with LTE fallback (A7670 HTTPS AT commands),
    GPS powered through a MOSFET for up to 90 s every 15 min, GPS time
    when NTP is unavailable
    - App and simulator: Li-ion voltage curve for battery percentage
    - Redraw the architecture, block and circuit diagrams and rewrite
    the circuit notes, README and the proposal: power budget, sizing,
    tables, costing and Summary of Rev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
2026-09-30 Connect-a-sensor guide, clearer empty states, desktop sidebar
    - Stations that never reported show "Sensor not connected yet" instead
    of blank values; developers get a 3-step guide on the station page
    (generate key, flash firmware, power on) with a ready config.h,
    "Test connection" and "Send a sample reading" buttons
    - New GET /api/v1/ingest/ping to check a sensor key without storing data
    - Overview explains an empty network instead of "Waiting for live data"
    - Wide screens: sidebar navigation and a two-column station list
    - Charts reload when a station sends its first reading
    - Optional Cloudflare tunnel profile for testing the installed app on
    phones; README: removing stations, phon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
2026-10-02 No accounts: public app, self-enrolling stations, team admin passcode
    - Viewing is public (stations, history, alerts, CSV, live WebSocket);
    user accounts, sign-up and the login screen are removed
    - Stations add themselves: on first power-on the firmware enrolls with
    the team secret (ENROLL_SECRET) and its ESP32 chip ID, gets its own key
    (kept in flash) and is named after the barangay at its GPS position
    (OpenStreetMap reverse geocoding); re-enrolling keeps its history
    - The team signs in under Settings -> Team admin with ADMIN_PASSCODE to
    rename stations, set thresholds, acknowledge alerts and remove or
    remove-and-block stations
    - Migration 004 drops users/owner_id, adds chip_id,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
    [config.example.h, ginhawa_node.ino, lte.h]
2026-10-02 Paper and diagrams: no accounts, self-adding stations, team admin
    - ERD: USERS removed; STATIONS gains chip_id and name_from_gps;
    new BLOCKED_DEVICES
    - Use case, context and Level 1 DFD: viewers need no account; the
    administrator signs in with the team passcode; process 1.0 becomes
    Register Station (hardware ID + team secret)
    - Proposal text (overview, ERD, use case, context, DFD, scalability,
    UI, software, installation, ISO 25010 security, functionality tests),
    new screenshots (Figures 10-15) and Summary of Revisions
    - Settings page: Team admin moved above Network
    Claude-Session: https://claude.ai/code/session_0148MYiEDhLTPm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
2026-10-02 Small admin login: link in Settings opens a separate login screen
    Settings no longer shows a passcode box. A small "Admin login" link at
    the bottom opens /admin, where the team enters the shared passcode;
    after logging in, Settings shows an Admin section with Log out.
    Proposal, use case diagram, Summary of Revisions and README updated
    (Figures 13-15: Settings, Admin Login, Station Settings).
    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
2026-10-10 Use the A7670SA's built-in GNSS for GPS; no status LEDs
    - Firmware: GPS now comes from the A7670SA (AT+CGNSSPWR / AT+CGPSINFO),
    switched on for up to 2 min every 15 min and only above 3.5 V; the
    separate GPS module, MOSFET and TinyGPSPlus are gone; LEDs default off
    - Circuit, block, architecture and context diagrams; circuit notes and
    parts list match the purchased parts (TPS63802, MT3608, Samsung 30Q,
    1S 10A BMS, 16/18/22 AWG wiring, PG7 glands)
    - Proposal: hardware, pin, power budget (8.1 / 12.2 Wh/day), sizing,
    location tracking, software and costing (P7,300-13,930); Summary of
    Revisions; README; simulator load; shopping list in docs/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
2026-10-21 Add station build manual for first-time builders
    18 stages from part checks to mounting, with 15 wiring figures, expected
    multimeter readings, I2C and modem test sketches, troubleshooting and a
    complete wiring list. Uses the parts actually bought (Beston 18650,
    TPS63020, E-WOITD BMS, CN3791 6 V) and matches the firmware pins.
    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
2026-10-21 Add printable PDF of the complete build manual (40 pages, A4)
    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
2026-10-21 Build manual: detailed beginner edition
    Five parts and 29 stages: electricity basics, a guide to every part and
    tool, safety, multimeter and soldering lessons with a practice board, then
    the build with per-stage parts/tools lists, explanations and failure fixes.
    Adds Arduino IDE, driver and app set-up walkthroughs, a 24-hour bench test,
    maintenance, troubleshooting, wiring list and glossary. 31 figures; PDF is
    81 pages, diagrams PDF regenerated.
    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
2026-10-22 Add hole-by-hole power board layout image
    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
2026-10-22 Add realistic view of the finished power board
    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
2026-10-22 Add power board inspection guide image
    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
2026-10-25 Add remaining build steps (stages A-M) as a printable PDF
    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
2026-10-25 Add complete build steps PDF (stages 1-16, battery pack to mounting)
    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
